MarkMan0/BalancingMotorbike/Schematic/Schematic.pdf

## 5V buck

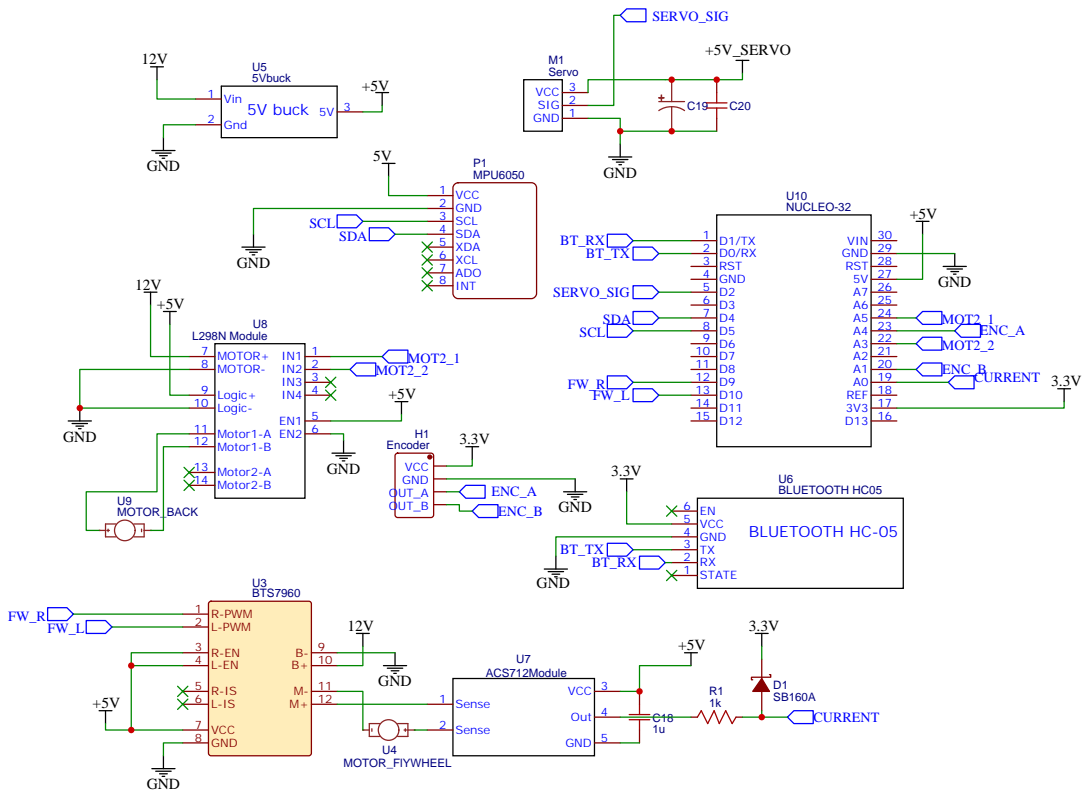
[picture p5: page 1]
