MarkMan0/BalancingMotorbike/STM32Project/Src/main.c

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

/* Includes ------------------------------------------------------------------*/
#include "main.h"
#include "adc.h"
#include "i2c.h"
#include "tim.h"
#include "usart.h"
#include "gpio.h"

/* USER CODE BEGIN Includes */
#include <string.h>
#include <stdio.h>
#include "stm32f3xx_ll_usart.h"
#include "MPU6050.h"
#include "orientation.h"
#include "MovementController.h"
#include "CurrentController.h"
#include "EncoderHandler.h"
#include "CommHandler.h"
#include "BalanceController.h"
/* USER CODE END Includes */


void SystemClock_Config(void);
/**
  * @brief  The application entry point.
  * @retval int
  */
int main(void)
{
  

  /* MCU Configuration--------------------------------------------------------*/

  /* Reset of all peripherals, Initializes the Flash interface and the Systick. */
  

  LL_APB2_GRP1_EnableClock(LL_APB2_GRP1_PERIPH_SYSCFG);
  LL_APB1_GRP1_EnableClock(LL_APB1_GRP1_PERIPH_PWR);

  NVIC_SetPriorityGrouping(NVIC_PRIORITYGROUP_4);

  /* System interrupt init*/

  /* Configure the system clock */
  SystemClock_Config();

  /* Initialize all configured peripherals */
  MX_GPIO_Init();
  MX_USART2_UART_Init();
  MX_I2C1_Init();
  MX_USART1_UART_Init();
  MX_TIM6_Init();
  MX_ADC1_Init();
  MX_TIM3_Init();
  MX_TIM1_Init();
  MX_TIM7_Init();
  MX_TIM16_Init();
  MX_TIM2_Init();
  /* USER CODE BEGIN 2 */

  /*	INTIALIZATION SEQUENCE:
   *
   *		1. Enable both USART
   * 		2. init mpu
   * 		3. enable ADC and flywheel PWM timer (0 pulse)
   * 		4. turn on servo
   * 		5. wait for user to place bike into known orientation
   * 		6. calculate gyroscope and accelerometer steady state errors
   * 		7. calculate current sensor 0 amp value
   * 		8. wait for user to place bike into upright position
   * 		9. Enable rear motor timer
   * 		10. Enable Encoder
   * 		11. Enable control loop timers
   *
   *
   */

  //USARTs enabled
  LL_USART_EnableIT_RXNE(USART2);
  LL_USART_EnableIT_RXNE(USART1);

  //init mpu
  volatile MPU6050 mpu = { 0 };	//initialize to 0, rest is done in init
  orientation.mpu = &mpu;
  MPU6050init((MPU6050*) &mpu);	//init sensor

  //init ADC with DMA and TIMER
  initDMA_ADC((uint32_t) (CCParams.adcBuff), 2);
  initADC();
  initTIM_FLYWHEEL();

  //enable encoder, before servo
  initEncoder();

  //enable servo in center position
  initServo();

  waitUser();	//wait for signal on serial

  /* *** START CALIBRATION *** */

  //calc IMU roll offset/error
  MPU6050CalcErr((MPU6050*) &mpu);	//calculate error
  calcCurrentSensorOffset();		//calculate ADC offset

  /* *** CALIBRATION END *** */

  waitUser();	//wait for second signal

  //enable rear motor
  initRearMotor();

  //Enable current controller
  initCurrCont();

  //Enable balance controller
  initBalanceController();




  /* USER CODE END 2 */

  /* Infinite loop */
  /* USER CODE BEGIN WHILE */



  while (1)
  {
	  if(mpu.readFlag) {
		  //keep read frequency @1kHz
		  MPU6050readForRoll((MPU6050*) &mpu);
		  mpu.readFlag = 0;
	  }
	  //MPU6050readForRoll(&mpu);

    /* USER CODE END WHILE */

    /* USER CODE BEGIN 3 */
  }
  /* USER CODE END 3 */
}

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
