MarkMan0/BalancingMotorbike/STM32Project/BalancingMotorbike.ioc

Mcu.UserName=STM32F303K8Tx
PA0.Signal=ADC1_IN1
PA1.Signal=S_TIM2_CH2
PA10.Signal=USART1_RX
PA11.Signal=S_TIM1_CH4
PA12.Signal=S_TIM16_CH1
PA15.Signal=USART2_RX
PA2.Signal=USART2_TX
PA4.Signal=S_TIM3_CH2
PA5.Signal=S_TIM2_CH1_ETR
PA6.Signal=S_TIM3_CH1
PA8.Signal=S_TIM1_CH1
PA9.Signal=USART1_TX
PB3.GPIO_Label=LED_PIN
PB3.Signal=GPIO_Output
PB6.Signal=I2C1_SCL
PB7.Signal=I2C1_SDA
