MarkMan0/BalancingMotorbike/STM32Project/Inc/main.h

#define LED_PIN_Pin LL_GPIO_PIN_3
#define LED_PIN_GPIO_Port GPIOB
#define NVIC_PRIORITYGROUP_0         ((uint32_t)0x00000007) /*!< 0 bit  for pre-emption priority,
#define NVIC_PRIORITYGROUP_1         ((uint32_t)0x00000006) /*!< 1 bit  for pre-emption priority,
#define NVIC_PRIORITYGROUP_2         ((uint32_t)0x00000005) /*!< 2 bits for pre-emption priority,
#define NVIC_PRIORITYGROUP_3         ((uint32_t)0x00000004) /*!< 3 bits for pre-emption priority,
#define NVIC_PRIORITYGROUP_4         ((uint32_t)0x00000003) /*!< 4 bits for pre-emption priority,
#define TIM_CC_LOOP			(TIM6)
#define TIM_SERVO			(TIM16)
#define TIM_REAR_PWM		(TIM3)
#define TIM_FLYWHELL_PWM	(TIM1)
#define TIM_BALANCE_LOOP	(TIM7)
#define TIM_ENC				(TIM2)
