MarkMan0/BalancingMotorbike/STM32Project/Src/EncoderHandler.c

#include <EncoderHandler.h>


volatile SpdTracker FWspeed = {0};


void initEncoder() {

	FWspeed.lastCnt = LL_TIM_GetAutoReload(TIM_ENC) / 2;
	FWspeed.ts = 1.0/50.0;		//to calculate speed

	LL_TIM_SetCounter(TIM2, FWspeed.lastCnt);
	LL_TIM_ClearFlag_UPDATE(TIM_ENC);
	LL_TIM_EnableIT_UPDATE(TIM_ENC);
	LL_TIM_EnableCounter(TIM_ENC);

	LL_TIM_EnableIT_UPDATE(TIM_SERVO);  //for velocity calculation

}
