MarkMan0/BalancingMotorbike/(commit log)

2019-11-23 Create empty STM32 project
2019-11-23 Add schematics
2019-11-24 Create first order low-pass and high-pass filters
2019-11-24 Extend struct with filters
2019-11-24 Enable I2C and re-generate code
2019-11-26 Re-generate code with i2c interrupt enabled and LL library
2019-11-26 read accelerometer data from MPU
2019-11-26 group MPU code, and use low pass filters
2019-11-27 Update schematics
2019-11-27 Add schematic do documentation
2019-11-28 also read gyro
2019-12-03 Re-generate code with timer enabled and servo control through serial
2019-12-04 Enable PWM on TIM3 CH2
2019-12-05 optimize i2c code
2019-12-05 simplify complementary filter
2019-12-05 remove accelerometer normalization
2019-12-05 calculate roll using complementary filter
2019-12-05 improve and simplify roll calculation
    Add functions to calculate only the roll of the system, using Y-axis
    accelerometer and gyro data
2019-12-05 add comments and fix roll calculation
    [MPU6050.c, MPU6050.h, i2c.h, orientation.c, orientation.h]
2019-12-30 Increase clock frequency and change pwm using potentiometer
2019-12-30 Create 50Hz PWM for the servo
2019-12-30 Add control logic for rear motor
2019-12-31 Enable PWM for both channels on TIM3 for rear motor
2019-12-31 Update servo positions
2020-01-01 Enable DMA for ADC
2020-01-02 Enable high frequency pwm on TIM1
2020-01-02 ADC trigger in the middle of PWM pulse
2020-01-02 implement clamped PI controller
2020-01-02 set current controller params via serial
2020-01-03 Use TIM16 for the servo
2020-01-04 Refactor current control loop
2020-01-04 extract current calculation
2020-01-04 Control current through BT interface
2020-01-04 change elif structure to switch-case
2020-01-04 Add more commands for current control loop
2020-01-04 Define aliases for timers
2020-01-04 Make commands case insensitive
2020-01-05 Enable TIM2 in Encoder mode
2020-01-05 Add speed calculation of flywheel @50Hz
2020-01-07 Remove low pass filter
2020-01-07 Rename encoder files and functions
2020-01-10 calculate IMU error
2020-01-10 read sensor in main, calc roll in ISR
2020-01-10 Add alias for led pin
2020-01-14 Fix calibration code
2020-01-14 add offset calibration for current controller
2020-01-17 Enable low pass filter in MPU
2020-01-18 Small fix on balance controller
    [BalanceController.c, BalanceController.h]
2020-01-18 Increase number of samples for calibration
2020-01-18 Slow down I2C
2020-01-19 Preven infinite loops in I2C
2020-01-19 fix I2C
2020-01-19 Limit max torque
2020-01-20 disable interrupt
2020-01-20 Disable injected adc channel, change balance frequency to 1kHz
2020-01-20 fix rear wheel pwm frequency
2020-01-20 change filter param
2020-01-20 update i2c timing
2020-01-21 Fix current controller limits
    [CurrentController.c, CurrentController.h]
2020-01-21 update servo position
2020-01-21 Include CAD files
