MarkMan0/BalancingMotorbike/(notices)

Notices in the files:
STM32Project/Inc/main.h:
© Copyright (c) 2019 STMicroelectronics.
All rights reserved.
